konradmoesch/nixie-clock/README.md

# nixie-clock
6-digit nixie-clock using ESP32, IN-4 and IN-6

## dependencies
https://github.com/judge2005/Eagle-and-KiCAD-Nixie-Libs
https://github.com/Hieromon/AutoConnect
