konradmoesch/nixie-clock/hardware/controller/Nixie-Clock-Controller.kicad_pcb

## KiCad design hardware/controller/Nixie-Clock-Controller.kicad_pcb (2022-01-17)

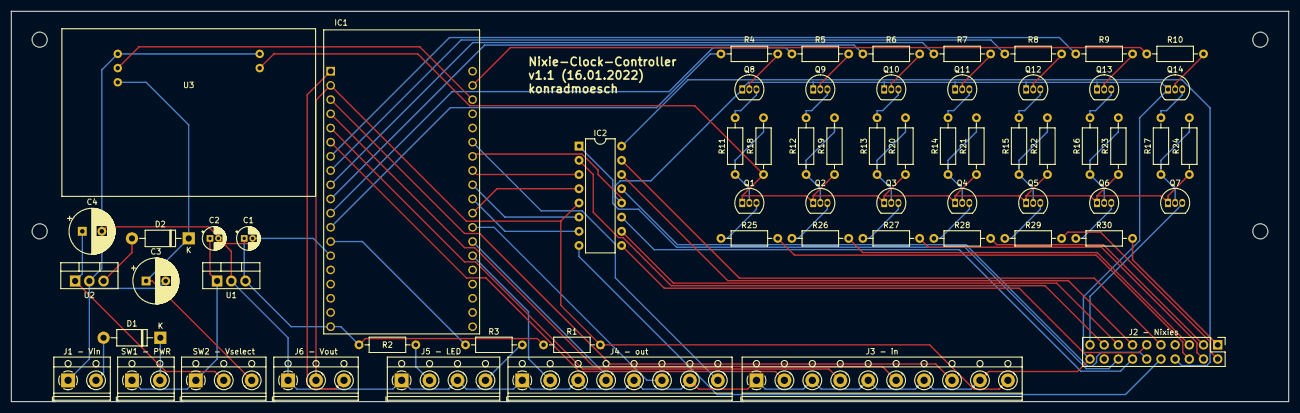
[picture p1: board Nixie-Clock-Controller.kicad_pcb from above]

Board: 2 copper layers, 228.6 x 69.8 mm, 67 parts (0 on the bottom side), 78 nets.

Parts:
C1, C2: 10uF; CP_Radial_D4.0mm_P1.50mm
C3, C4: 100uF 50V; CP_Radial_D8.0mm_P3.50mm
D1, D2: 1N4001; D_DO-41_SOD81_P10.16mm_Horizontal
H1, H2, H3, H4: MountingHole; MountingHole_2.7mm_M2.5
IC1: ESP32-DEVKITC-V4; MODULE_ESP32-DEVKITC-32D
IC2: 74141; DIP-16_W7.62mm
J1 - Vin: 9/12-35V DC in; TerminalBlock_RND_205-00012_1x02_P5.00mm_Horizontal
J2 - Nixies: Nixies-Connector; PinHeader_2x10_P2.54mm_Vertical
J3 - in: Input; TerminalBlock_RND_205-00020_1x10_P5.00mm_Horizontal
J4 - out: Output; TerminalBlock_RND_205-00018_1x08_P5.00mm_Horizontal
J5 - LED: LEDs; TerminalBlock_RND_205-00014_1x04_P5.00mm_Horizontal
J6 - Vout: power_out; TerminalBlock_RND_205-00013_1x03_P5.00mm_Horizontal
Q1, Q2, Q3, Q4, Q5, Q6, Q7: MPSA92; TO-92_Inline
Q8, Q9, Q10, Q11, Q12, Q13, Q14: MPSA42; TO-92_Inline
R1: 1k; R_Axial_DIN0207_L6.3mm_D2.5mm_P10.16mm_Horizontal
R2, R3: 220R; R_Axial_DIN0207_L6.3mm_D2.5mm_P10.16mm_Horizontal
R4, R5, R6, R7, R8, R9, R10: 33k; R_Axial_DIN0207_L6.3mm_D2.5mm_P10.16mm_Horizontal
R11, R12, R13, R14, R15, R16, R17: 470k; R_Axial_DIN0207_L6.3mm_D2.5mm_P10.16mm_Horizontal
R18, R19, R20, R21, R22, R23, R24: 100k; R_Axial_DIN0207_L6.3mm_D2.5mm_P10.16mm_Horizontal
R25, R26, R27, R28, R29, R30: 10k; R_Axial_DIN0207_L6.3mm_D2.5mm_P10.16mm_Horizontal
SW1 - PWR: on/off; TerminalBlock_RND_205-00012_1x02_P5.00mm_Horizontal
SW2 - Vselect: in voltage select; TerminalBlock_RND_205-00013_1x03_P5.00mm_Horizontal
U1: L7805; TO-220-3_Vertical
U2: L7809; TO-220-3_Vertical
U3: NCH6300HV; NCH_6300_HV

Connections:
/a1: J2 - Nixies.1, R30.2
/a2: J2 - Nixies.2, R29.2
/a3: J2 - Nixies.3, R28.2
/a4: J2 - Nixies.4, R27.2
/a5: J2 - Nixies.5, R26.2
/a6: J2 - Nixies.6, R25.2
/c0: IC2.16 (~Q0), J2 - Nixies.8
/c1: IC2.15 (~Q1), J2 - Nixies.9
/c2: IC2.8 (~Q2), J2 - Nixies.10
/c3: IC2.9 (~Q3), J2 - Nixies.11
/c4: IC2.13 (~Q4), J2 - Nixies.12
/c5: IC2.14 (~Q5), J2 - Nixies.13
/c6: IC2.11 (~Q6), J2 - Nixies.14
/c7: IC2.10 (~Q7), J2 - Nixies.15
/c8: IC2.1 (~Q8), J2 - Nixies.16
/c9: IC2.2 (~Q9), J2 - Nixies.17
/da: J2 - Nixies.19, Q7.3 (C)
/in_1: IC1.3 (SENSOR_VP), J3 - in.8
/in_2: IC1.4 (SENSOR_VN), J3 - in.6
/in_3: IC1.5 (IO34), J3 - in.4
/in_4: IC1.6 (IO35), J3 - in.2
/led_status: J5 - LED.4, R3.2
/out_1: IC1.25 (IO21), J4 - out.8
/out_2: IC1.31 (IO16), J4 - out.6
/out_3: IC1.32 (IO4), J4 - out.4
/out_4: IC1.33 (IO0), J4 - out.2
/shdn: IC1.22 (IO22), U3.2 (SHDN)
GND: C1.2, C2.2, C3.2, C4.2, IC1.14 (GND1), IC1.26 (GND2), IC2.12 (GND), J1 - Vin.1, J2 - Nixies.20, J3 - in.1, J3 - in.3, J3 - in.5, J3 - in.7, J3 - in.9, J4 - out.1, J4 - out.3, J4 - out.5, J4 - out.7, J5 - LED.1, J5 - LED.3, J6 - Vout.1, Q8.1 (E), Q9.1 (E), Q10.1 (E), Q11.1 (E), Q12.1 (E), Q13.1 (E), Q14.1 (E), U1.2 (GND), U2.2 (GND), U3.1 (GND), U3.4 (GND)
unnamed: C1.1, IC1.19 (EXT_5V), R1.1, R2.1, U1.3 (OUT)
unnamed: C2.1, SW1 - PWR.1, SW2 - Vselect.1, U1.1 (IN)
unnamed: C3.1, D2.1 (K), SW2 - Vselect.3, U3.3 (VIN)
unnamed: C4.1, SW2 - Vselect.2, U2.1 (IN)
unnamed: D1.1 (K), SW1 - PWR.2
unnamed: D1.2 (A), J1 - Vin.2
unnamed: D2.2 (A), U2.3 (OUT)
unnamed: IC1.1 (3V3), J6 - Vout.3
unnamed: IC1.7 (IO32), R9.2
unnamed: IC1.8 (IO33), R8.2
unnamed: IC1.9 (IO25), R7.2
unnamed: IC1.10 (IO26), R6.2
unnamed: IC1.11 (IO27), R5.2
unnamed: IC1.12 (IO14), R4.2
unnamed: IC1.13 (IO12), R3.1
unnamed: IC1.21 (IO23), R10.2
unnamed: IC1.27 (IO19), IC2.3 (A)
unnamed: IC1.28 (IO18), IC2.6 (B)
unnamed: IC1.29 (IO5), IC2.7 (C)
unnamed: IC1.30 (IO17), IC2.4 (D)
unnamed: J5 - LED.2, R2.2
unnamed: Q1.1 (E), Q2.1 (E), Q3.1 (E), Q4.1 (E), Q5.1 (E), Q6.1 (E), Q7.1 (E), R18.1, R19.1, R20.1, R21.1, R22.1, R23.1, R24.1, U3.5 (HV)
unnamed: Q1.2 (B), R11.1, R18.2
unnamed: Q1.3 (C), R25.1
unnamed: Q2.2 (B), R12.1, R19.2
unnamed: Q2.3 (C), R26.1
unnamed: Q3.2 (B), R13.1, R20.2
unnamed: Q3.3 (C), R27.1
unnamed: Q4.2 (B), R14.1, R21.2
unnamed: Q4.3 (C), R28.1
unnamed: Q5.2 (B), R15.1, R22.2
unnamed: Q5.3 (C), R29.1
unnamed: Q6.2 (B), R16.1, R23.2
unnamed: Q6.3 (C), R30.1
unnamed: Q7.2 (B), R17.1, R24.2
unnamed: Q8.2 (B), R4.1
unnamed: Q8.3 (C), R11.2
unnamed: Q9.2 (B), R5.1
unnamed: Q9.3 (C), R12.2
unnamed: Q10.2 (B), R6.1
unnamed: Q10.3 (C), R13.2
unnamed: Q11.2 (B), R7.1
unnamed: Q11.3 (C), R14.2
unnamed: Q12.2 (B), R8.1
unnamed: Q12.3 (C), R15.2
unnamed: Q13.2 (B), R9.1
unnamed: Q13.3 (C), R16.2
unnamed: Q14.2 (B), R10.1
unnamed: Q14.3 (C), R17.2
VCC: IC1.2 (EN), IC2.5 (VCC), J3 - in.10, J6 - Vout.2, R1.2
