konradmoesch/nixie-clock/hardware/nixies/Nixie-Clock-Nixies.kicad_pcb

## KiCad design hardware/nixies/Nixie-Clock-Nixies.kicad_pcb (2022-01-04)

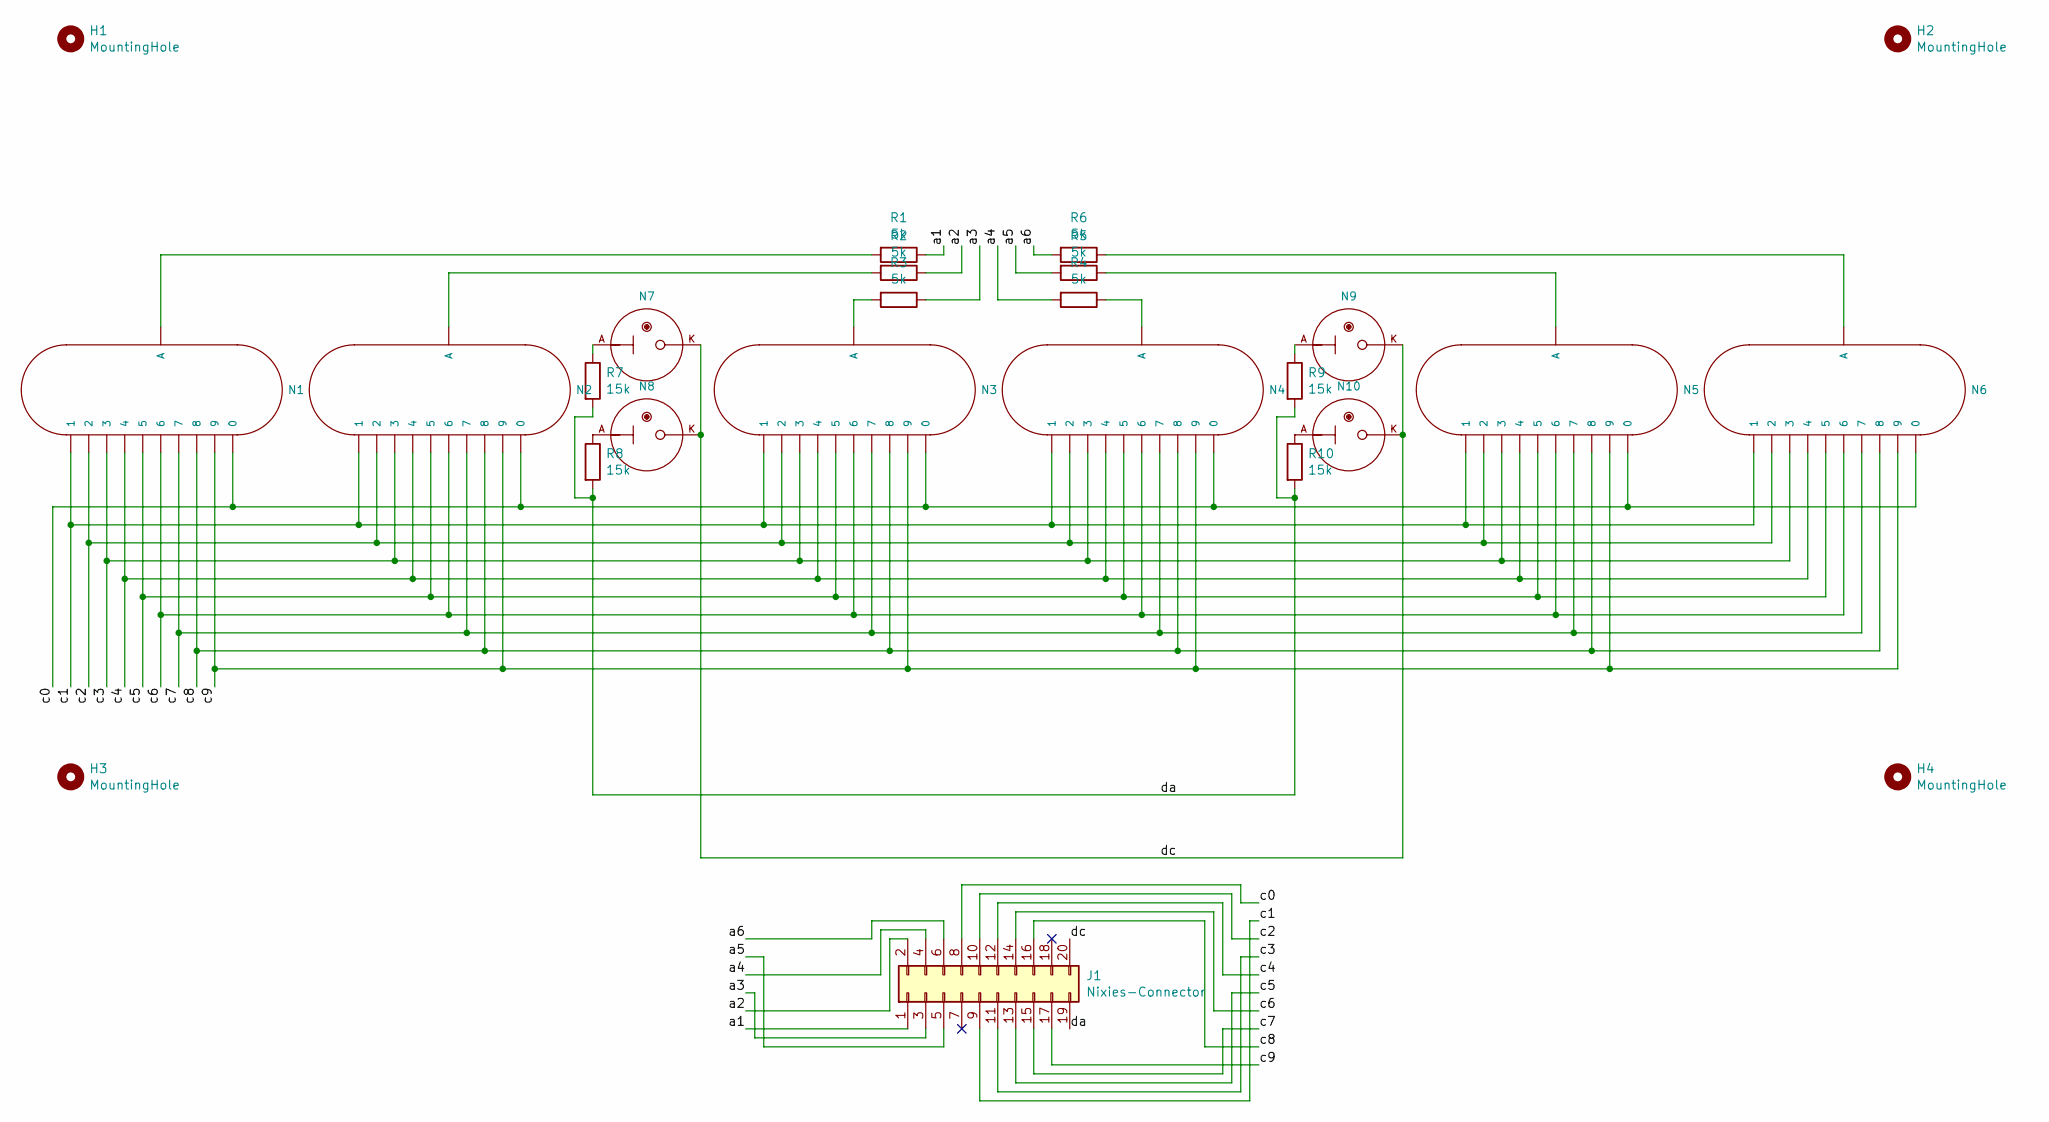
[picture p2: schematic Nixie-Clock-Nixies.kicad_sch, Nixie-Clock: Nixies]

Parts:
H1, H2, H3, H4: MountingHole; MountingHole_2.7mm_M2.5
J1: Nixies-Connector; PinHeader_2x10_P2.54mm_Horizontal_with_Interlock
N1, N2, N3, N4, N5, N6: IN-4; nixies-us-IN-4-DSUB
N7, N8, N9, N10: IN-6; nixies-us-IN-6
R1, R2, R3, R4, R5, R6: 5k; R_Axial_DIN0207_L6.3mm_D2.5mm_P10.16mm_Horizontal
R7, R8, R9, R10: 15k; R_Axial_DIN0207_L6.3mm_D2.5mm_P10.16mm_Horizontal

Connections:
/a1: J1.1, R1.1
/a2: J1.2, R2.1
/a3: J1.3, R3.1
/a4: J1.4, R4.2
/a5: J1.5, R5.2
/a6: J1.6, R6.2
/c0: J1.8, N1.0, N2.0, N3.0, N4.0, N5.0, N6.0
/c1: J1.9, N1.1, N2.1, N3.1, N4.1, N5.1, N6.1
/c2: J1.10, N1.2, N2.2, N3.2, N4.2, N5.2, N6.2
/c3: J1.11, N1.3, N2.3, N3.3, N4.3, N5.3, N6.3
/c4: J1.12, N1.4, N2.4, N3.4, N4.4, N5.4, N6.4
/c5: J1.13, N1.5, N2.5, N3.5, N4.5, N5.5, N6.5
/c6: J1.14, N1.6, N2.6, N3.6, N4.6, N5.6, N6.6
/c7: J1.15, N1.7, N2.7, N3.7, N4.7, N5.7, N6.7
/c8: J1.16, N1.8, N2.8, N3.8, N4.8, N5.8, N6.8
/c9: J1.17, N1.9, N2.9, N3.9, N4.9, N5.9, N6.9
/da: J1.19, R7.2, R8.2, R9.2, R10.2
/dc: J1.20, N7.K, N8.K, N9.K, N10.K
unnamed: N1.A3 (A), R1.2
unnamed: N2.A3 (A), R2.2
unnamed: N3.A3 (A), R3.2
unnamed: N4.A3 (A), R4.1
unnamed: N5.A3 (A), R5.1
unnamed: N6.A3 (A), R6.1
unnamed: N7.A, R7.1
unnamed: N8.A, R8.1
unnamed: N9.A, R9.1
unnamed: N10.A, R10.1

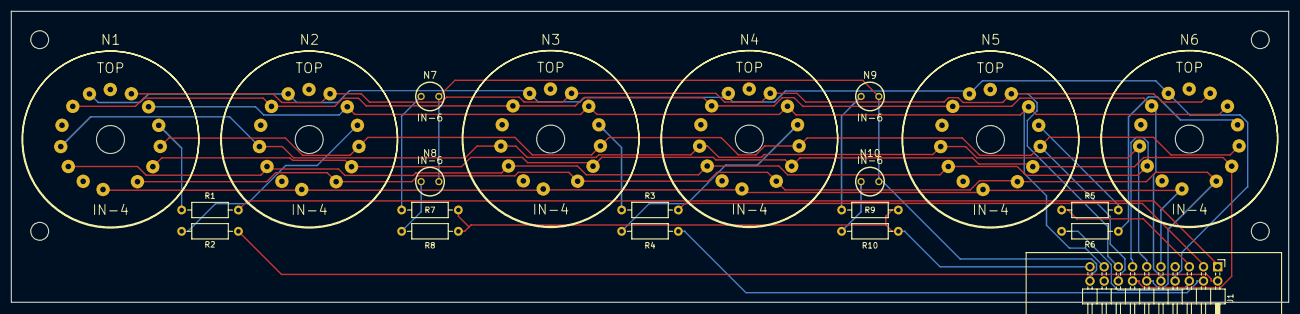
[picture p3: board Nixie-Clock-Nixies.kicad_pcb from above]

Board: 2 copper layers, 228.6 x 52.1 mm, 25 parts (0 on the bottom side), 28 nets.
