konradmoesch/nixie-clock/software/nixie-clock/change_c_cpp_version.py

Import("env")

c = env["CFLAGS"]
c = [x for x in c if not "-std" in x]
c += ["-std=gnu99"]
env.Replace(CFLAGS=c)

cxx = env["CXXFLAGS"]
cxx = [x for x in cxx if not "-std" in x]
cxx += ["-std=c++11"]
env.Replace(CXXFLAGS=cxx)
