konradmoesch/nixie-clock/(commit log)

2021-12-23 Add hardware schematics
    [Nixie-Clock-Controller.kicad_pcb, Nixie-Clock-Controller.sch, Nixie-Clock-Nixies.kicad_pcb, Nixie-Clock-Nixies.sch]
2021-12-24 Switch to platform.io and Clion
2021-12-25 Add screw terminals for I/O, Improve PCB layout
    [Nixie-Clock-Controller.kicad_pcb, Nixie-Clock-Controller.sch, Nixie-Clock-Nixies.kicad_pcb, Nixie-Clock-Nixies.sch]
2021-12-25 Add Mounting Holes to PCB, Improve Routing, Add power pin header, Use correct connector footprint
    [Nixie-Clock-Controller.kicad_pcb, Nixie-Clock-Controller.sch, Nixie-Clock-Nixies.kicad_pcb, Nixie-Clock-Nixies.sch]
2021-12-25 Fix libraries used in Nixie-Clock-Nixies
    [Nixie-Clock-Nixies.kicad_pcb, Nixie-Clock-Nixies.sch]
2021-12-25 Fix libraries used in Nixie-Clock-Controller
    [Nixie-Clock-Controller.kicad_pcb, Nixie-Clock-Controller.sch]
2021-12-25 Rename folder
    [Nixie-Clock-Nixies.kicad_pcb, Nixie-Clock-Nixies.sch]
2021-12-28 Shrink pcbs
    [Nixie-Clock-Controller.kicad_pcb, Nixie-Clock-Nixies.kicad_pcb]
2021-12-28 Improve text label positioning
    [Nixie-Clock-Controller.kicad_pcb, Nixie-Clock-Nixies.kicad_pcb]
2021-12-28 Change Mountingholes to M3
    [Nixie-Clock-Controller.kicad_pcb, Nixie-Clock-Nixies.kicad_pcb]
2021-12-30 Fix path error
    [Nixie-Clock-Nixies.kicad_pcb]
2021-12-30 Fix text labels
    [Nixie-Clock-Nixies.kicad_pcb]
2021-12-30 Fix nixie drill hole size
    [Nixie-Clock-Nixies.kicad_pcb]
2022-01-02 Add error handling when config invalid
    [StorageController.cpp]
2022-01-03 Add BOM
    [BOM.csv]
2022-01-03 Fix uF in BOM, Fix 74141 count
    [BOM.csv]
2022-01-03 Fix wrong pin mapping on U3
    [Nixie-Clock-Controller.kicad_pcb]
2022-01-04 Move nixie control code to other core, Add some very basic ghosting prevention
    [NixieController.cpp, StorageController.cpp, main.cpp]
2022-01-04 Move to Kicad 6
    [Nixie-Clock-Controller.kicad_pcb, Nixie-Clock-Controller.kicad_sch, Nixie-Clock-Controller.sch, Nixie-Clock-Nixies.kicad_pcb, Nixie-Clock-Nixies.kicad_sch, Nixie-Clock-Nixies.sch]
2022-01-16 Fix pin Layout again
    [Nixie-Clock-Controller.kicad_pcb, Nixie-Clock-Controller.kicad_sch]
2022-01-16 fix wrong transistor connections
    [Nixie-Clock-Controller.kicad_pcb, Nixie-Clock-Controller.kicad_sch]
2022-01-16 Improve transistor numbering
    [Nixie-Clock-Controller.kicad_pcb, Nixie-Clock-Controller.kicad_sch]
2022-01-16 Add version text
    [Nixie-Clock-Controller.kicad_pcb]
2022-01-16 Update version
    [Nixie-Clock-Controller.kicad_pcb, Nixie-Clock-Controller.kicad_sch]
2022-01-17 Improve labels
    [Nixie-Clock-Controller.kicad_pcb, Nixie-Clock-Controller.kicad_sch]
